fjpolo/open-ndt-weld/docs/images/mfl_probe_build.jpg

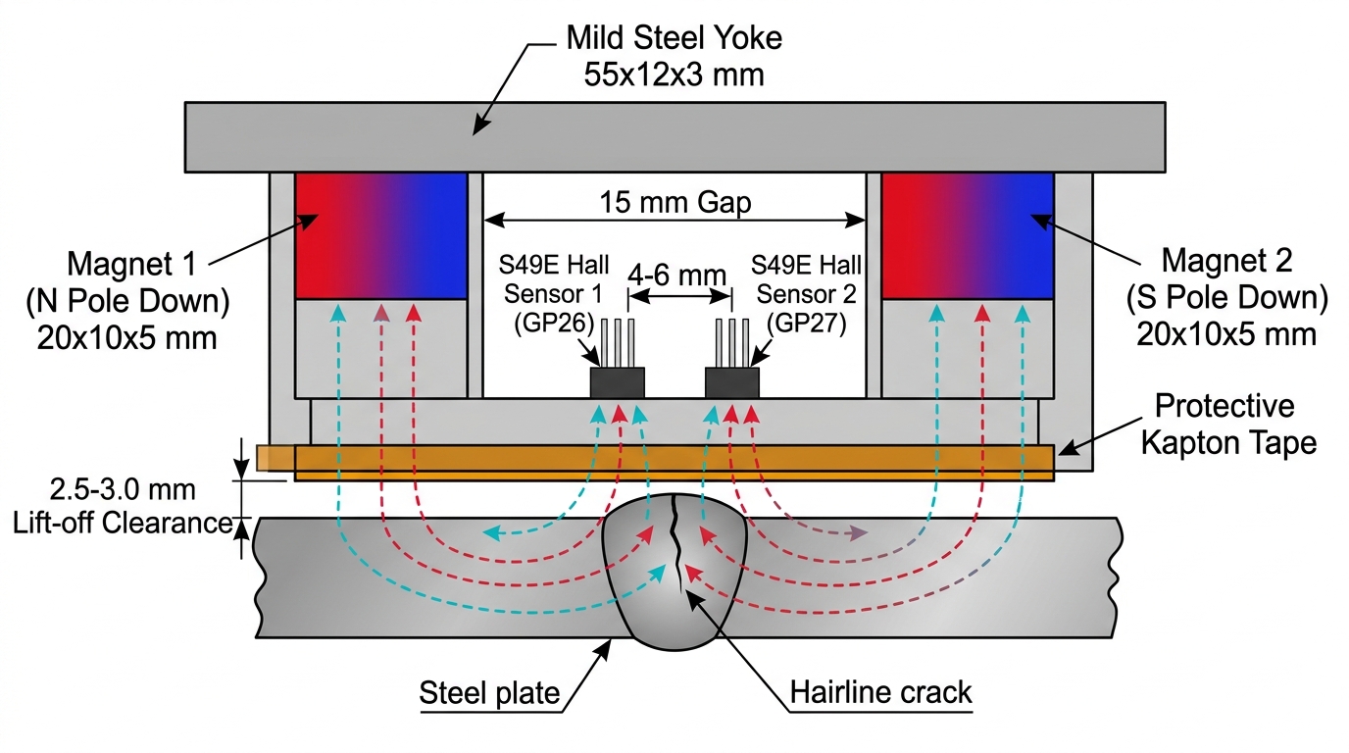
docs/images/mfl_probe_build.jpg
