fjpolo/open-ndt-weld/docs/images/rp2040_wiring_schematic.jpg

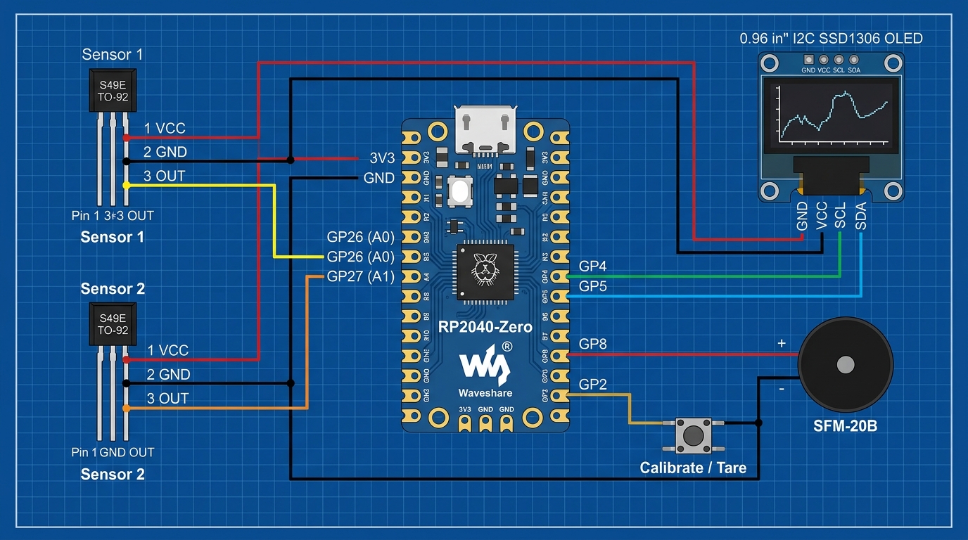
docs/images/rp2040_wiring_schematic.jpg
