fjpolo/open-ndt-weld/(commit log)

2026-11-13 Initial commit: OpenNDT Weld Inspector (Tier 1 RP2040-Zero MFL Gradiometer & Tier 2 Tang Nano 9K ET)
2026-11-13 Add parametric OpenSCAD 3D-printable MFL gradiometer probe housing
    [mfl_gradiometer_housing.scad]
2026-11-13 Use CALIBRATING... on OLED during baseline calibration
